ctesorierog/vehicle-sorting-platform/firmware/sensor_board/secrets.example.h

// Copy this file to secrets.h and fill in your own values (secrets.h is git-ignored).
#pragma once
#define STASSID "your-wifi-ssid"
#define STAPSK  "your-wifi-password"
#define BACKEND_HOST "http://your-backend-host:8000"
