ctesorierog/vehicle-sorting-platform/(commit log)

2026-10-22 Sensor board firmware as used in the demo (credentials moved to secrets.h)
    Claude-Session: https://claude.ai/code/session_016JGKCcSRweMckJnqyPtgXW
2026-10-22 Fix vehicle classification logic
    - 'if (luz > 100.)' had no braces, so POST(NONE) ran on every loop.
    - 'if (has_vehicle = false)' assigned instead of compared, so HEAVY/LIGHT were never sent.
    - Classify once per vehicle; thresholds named as constants.
    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
    [sensor_board.ino]
2026-10-23 Rebuild from team slides: final design, images, prototype; link to Asempere123123/making
